krutikdg/FPV_Crawler/CAD/complete(with dummies).step

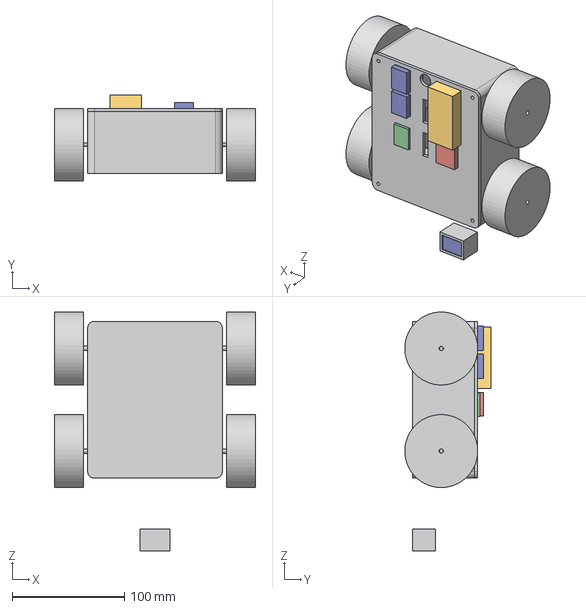
[picture p1: CAD file, 2026-11-04]
CAD/complete(with dummies).step
179.2 x 77.0 x 212.9 mm
