krutikdg/FPV_Crawler/CAD/complete(without dummies).step

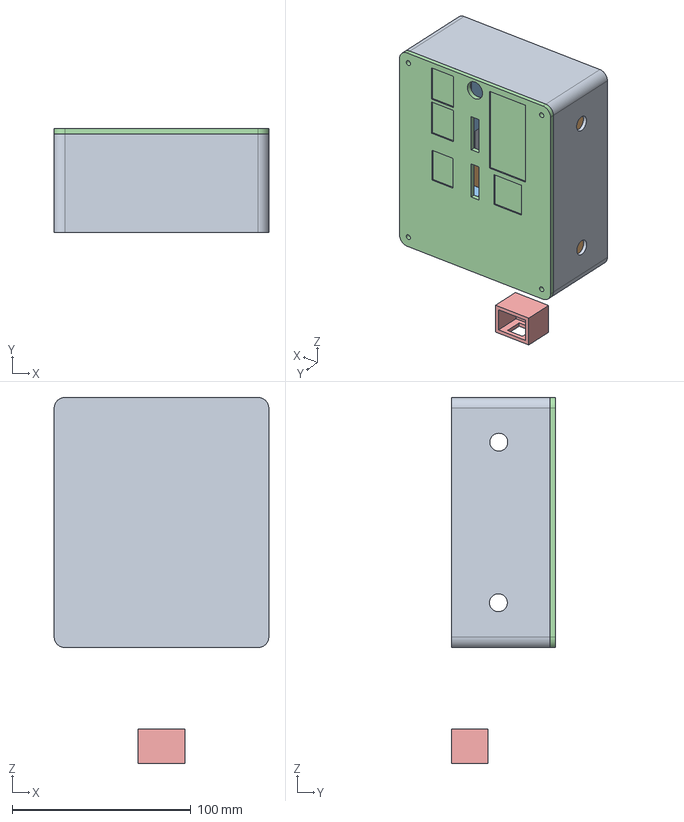
[picture p2: CAD file, 2026-11-04]
CAD/complete(without dummies).step
120.0 x 58.0 x 204.6 mm
