krutikdg/FPV_Crawler/CAD/clamps.step

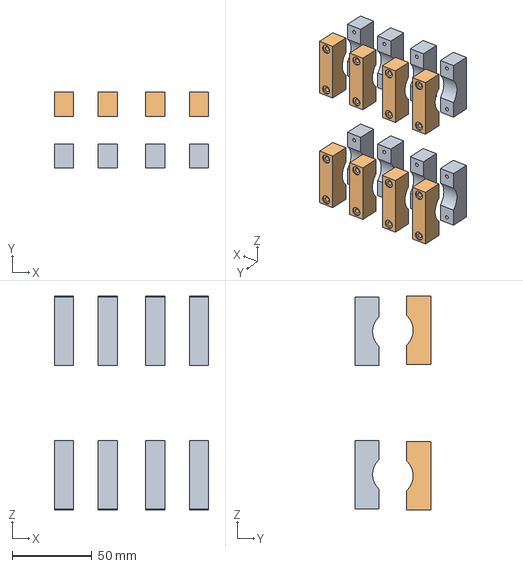
[picture p3: CAD file, 2026-11-04]
CAD/clamps.step
97.0 x 47.9 x 134.4 mm
