krutikdg/FPV_Crawler/CAD/Base.stl

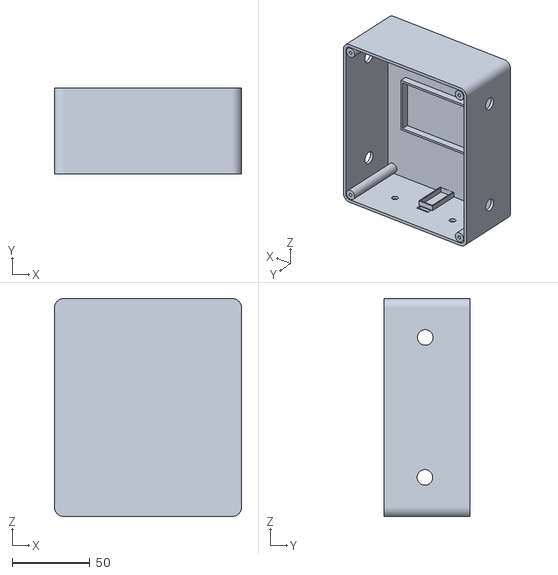
[picture p4: CAD file, 2026-11-04]
CAD/Base.stl
120.0 x 55.0 x 139.8
