krutikdg/FPV_Crawler/CAD/UpperClamps.stl

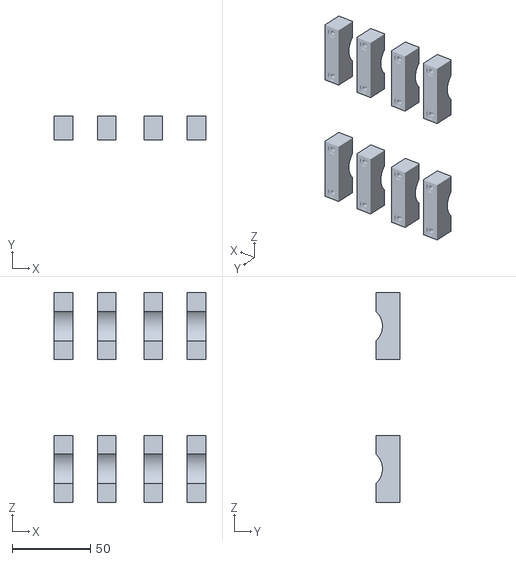
[picture p5: CAD file, 2026-11-04]
CAD/UpperClamps.stl
97.0 x 15.5 x 134.4
