krutikdg/FPV_Crawler/CAD/Deck.stl

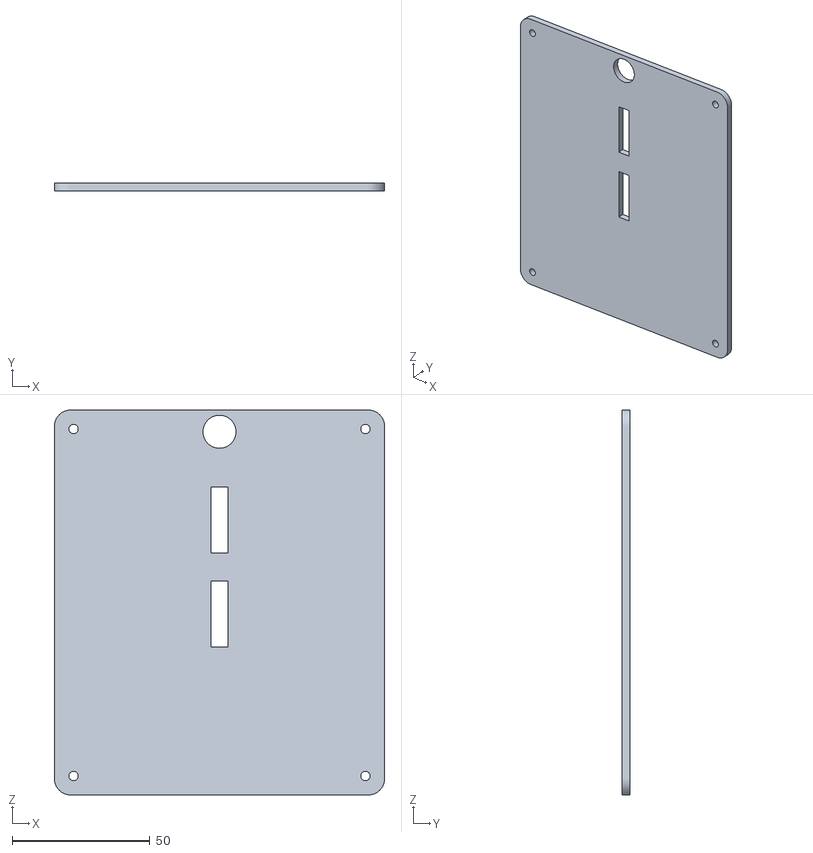
[picture p6: CAD file, 2026-11-04]
CAD/Deck.stl
120.0 x 3.00 x 139.8
