krutikdg/FPV_Crawler/CAD/CameraCradle.stl

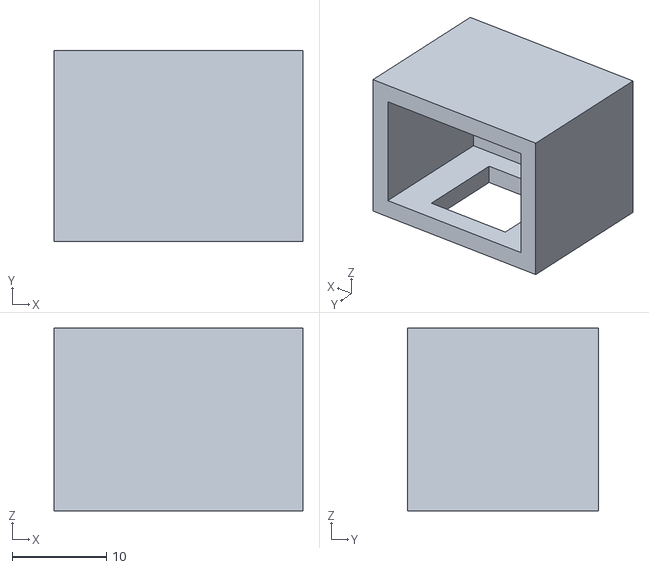
[picture p7: CAD file, 2026-11-04]
CAD/CameraCradle.stl
26.4 x 20.2 x 19.4
