krutikdg/FPV_Crawler/CAD/LowerClamps.stl

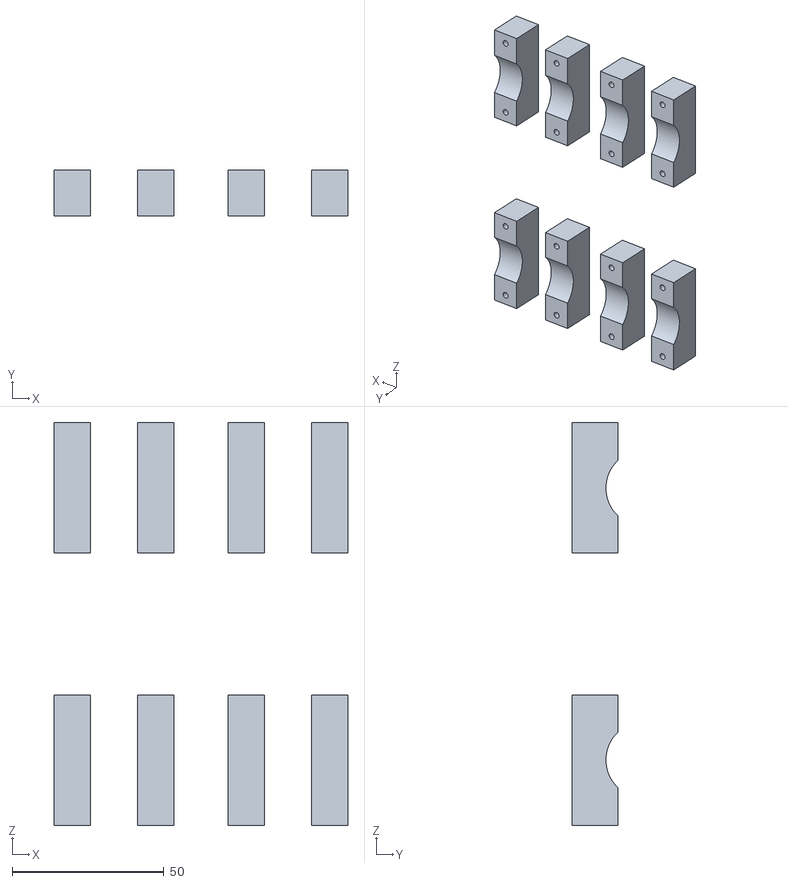
[picture p8: CAD file, 2026-11-04]
CAD/LowerClamps.stl
97.0 x 15.1 x 133.0
