krutikdg/FPV_Crawler/(list of files, cad)

Other CAD files:
CAD/clamps.f3d
CAD/complete(with dummies).f3d
CAD/complete(without dummies).f3d
