krutikdg/FPV_Crawler/(commit log)

2026-11-04 added CAD
    [Base.stl, CameraCradle.stl, Deck.stl, LowerClamps.stl, UpperClamps.stl, complete(with dummies).f3d, complete(with dummies).step, complete(without dummies).f3d]
2026-11-04 added BOM
2026-11-04 updated Readme and added BOM csv
    [BOM.csv]
2026-11-04 Added pin map
2026-11-04 Add CAD Models section to README
    Added CAD models section with images and descriptions for various components.
2026-11-04 added clamps.f3d
    [clamps.f3d]
2026-11-04 added clamps.step
    [clamps.step]
2026-11-06 Add assembly guide and troubleshooting section to README
    Added a detailed assembly guide with steps for preparation, wiring, and troubleshooting for the project.
